marcelbonnici/turntable/basis.png

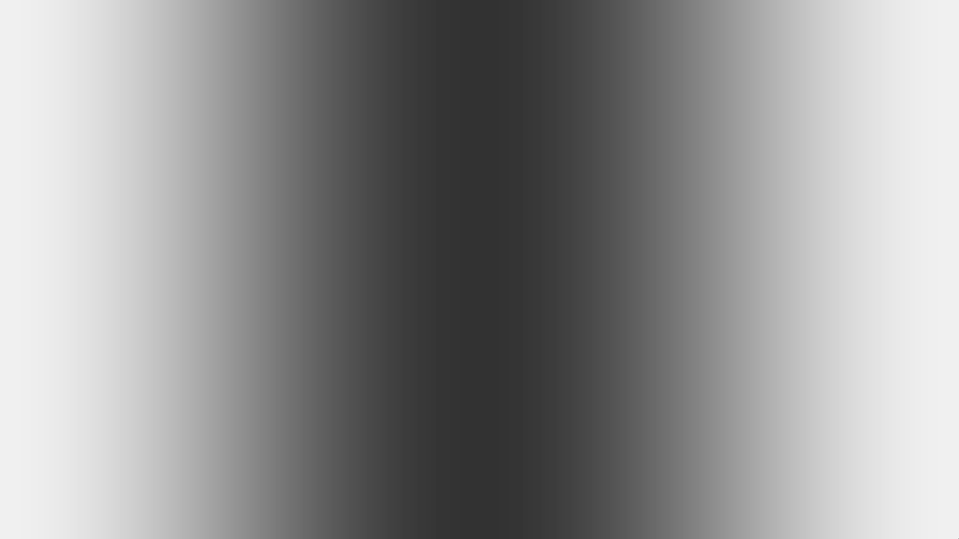
basis.png
