marcelbonnici/turntable/README-images/all_the_pics.png

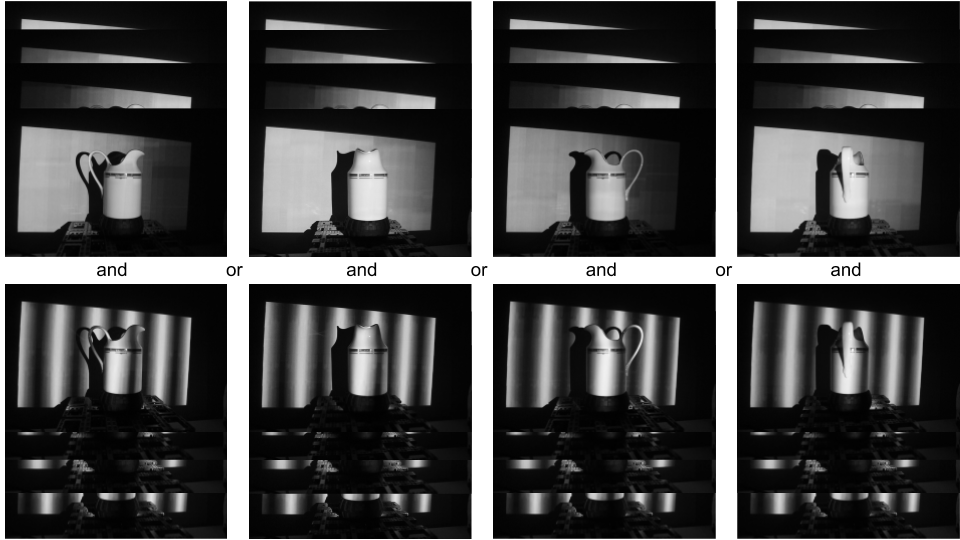
README-images/all_the_pics.png
