marcelbonnici/turntable/README-images/depth_map.png

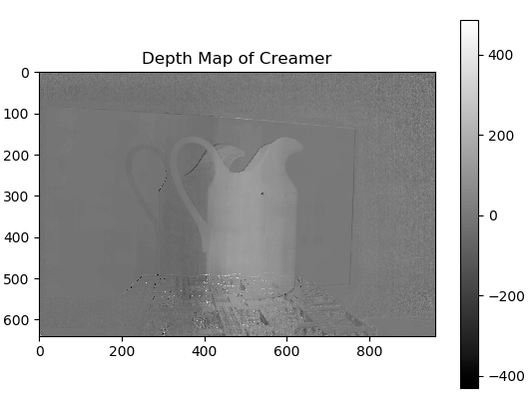
README-images/depth_map.png
