marcelbonnici/turntable/README-images/sample.png

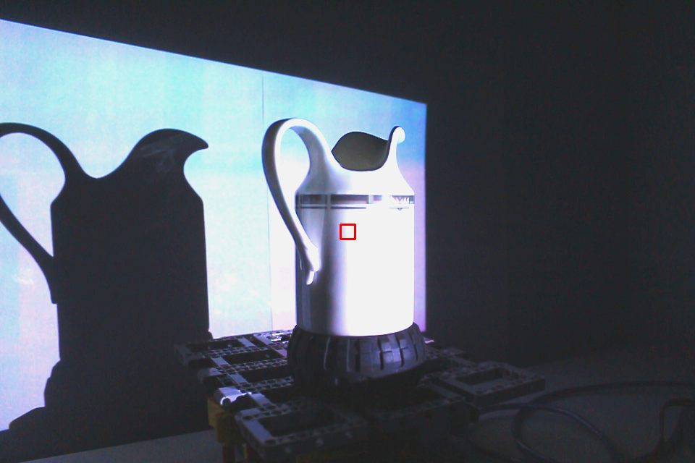
README-images/sample.png
