marcelbonnici/turntable/resize_image.png

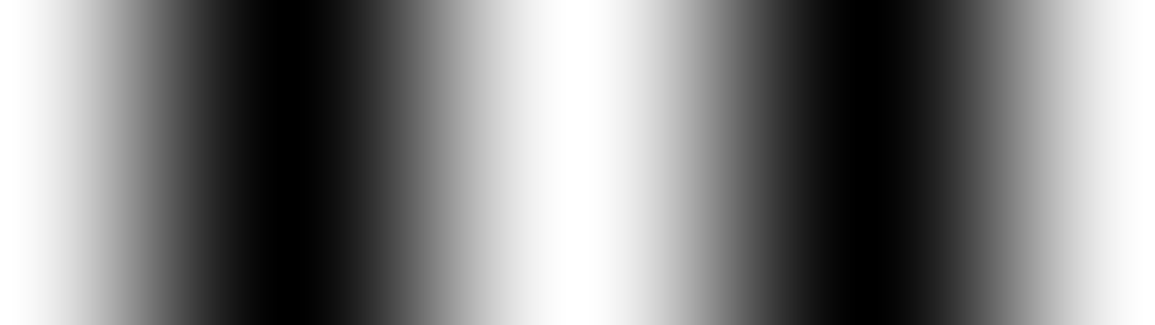
resize_image.png
