marcelbonnici/turntable/(commit log)

2020-04-23 Arduino and Python first draft with Tkinter
2020-06-07 Exposure modified for an alright calibration test
2020-06-07 Helpful calibration plotting code
2020-06-09 Optimal calibration for a setup of 22ms exposure time
    [plot.csv]
2020-06-10 First draft of phase retrieval
    [plot.csv]
2020-06-11 Second attempt at phase map; uses viridis color
    [plot.csv]
2020-06-29 Decreased run time for calibration
    [fitplot.csv, plot.csv]
2020-08-08 Added files made compatible with my Logitech webcam
    [lcherrypick.csv, lfitplot.csv, lplot.csv]
2020-08-16 Progress with DSLR up to completing a subpar 4-step fringe
    [lcherrypick.csv]
2020-08-20 Made a pixel-by-pixel calibration; adding it to fringe proj is next
    [pixelcalibrate.csv]
2020-08-28 Removed obsolete files
    [fitplot.csv, lcherrypick.csv, lfitplot.csv, lplot.csv, pixelcalibrate.csv, plot.csv]
2020-08-28 Removed obsolete files to only provide helpful ones
    [projection_lookup_table.csv]
2020-08-30 Added shaft coupling parts to lxf/LDD file
