marcelbonnici/turntable/README-images/bearings.jpg

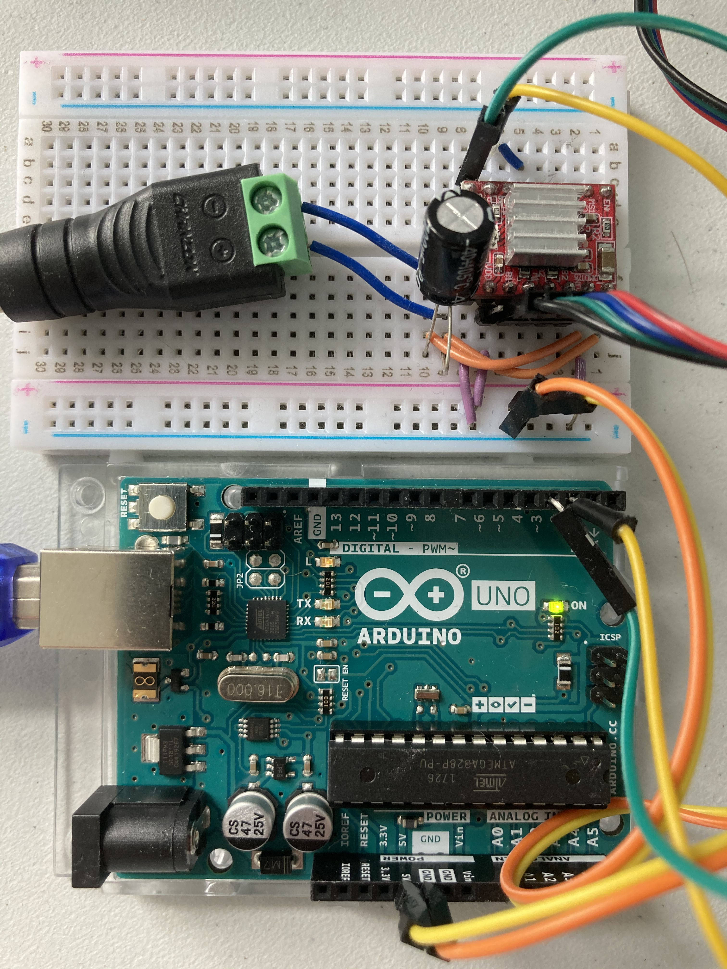
README-images/bearings.jpg
