marcelbonnici/turntable/README-images/2by3.jpeg

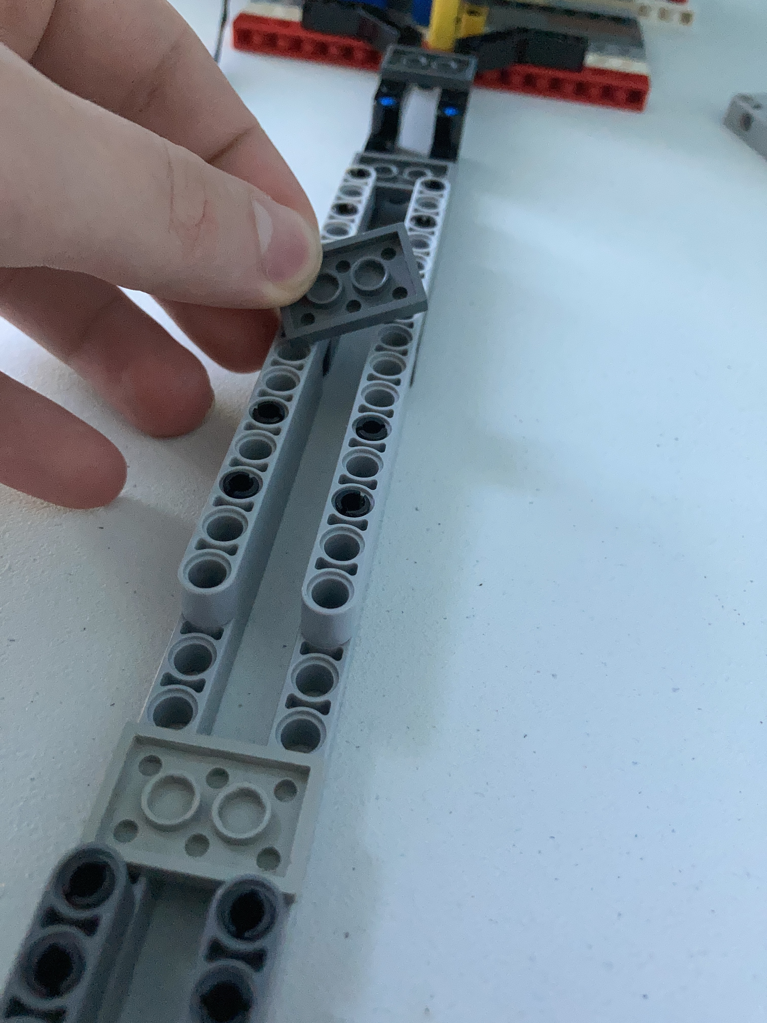
[picture p4: README-images/2by3.jpeg]
README-images/2by3.jpeg
